iagoPB/Selva-Estacao/(commit log)

2026-10-31 firmware da estacao (pir, balanca, dht, sd) e manuais de montagem
2026-10-31 servidor da estacao: serial, camera, gemini, catalogo, peso, registro
2026-10-31 readme, gitignore e script de deploy pra tv box
